LHelge/BCD-watch/HW/README.md

# Hardware
This directory contains all the hardware related stuff

## Datasheets
Documentation for the components used

## Libraries
Both symbol and footprint libraries for the PCB design

## PCB_CR2032
First version of the watch PCB, designed to use with a CR2043 battery
