LHelge/BCD-watch/HW/PCB_CR2032/README.md

# PCB_CR2032
Design of watch PCB to be used with a CR2032 coin cell battery

## Schematic
TODO: add this as images here

## BoM

Reference | Value | Make | Mouser part# | Part | Qty
--------- | ----- | ---- | ---- | ------ | ---
BT1 | CR2032 | Linx | 712-BAT-HLD-001 | BAT-HLD-001 | 1
C1, C2 | 20pF | Yageo | 603-CC805JRNPO9BN200 | CC0805JRNPO9BN200 | 2
C4-C9, C14, C15 | 100nF | Yageo | 603-CC805KRX7R9BB104 | CC0805KRX7R9BB104 | 8
C12 | 11mF | SII | 628-CPH3225A-2K | CPH3225A | 1
C3, C11, C13 | 10uF | Yageo | 603-CC805KKX7R6BB106 | CC0805KKX7R6BB106 | 3
D1-D3 | BAR43CFILM | ST | 511-BAR43CFILM | BAR43CFILM | 3
H00-H03,<br> H10-H13,<br> M00-M03,<br> M10-M13,<br> S00-S03,<br> S10-S13 | LED | Kingbright | 604-APTR3216SECKJ3 | APTR3216SECK/J3-PRV | 24
J1 | STDC14 | Amphenol  | 649-221121-00014T4LF | 20021121-00014T4LF | 1
R1-R20, R23-R26 | 1k | Yageo | 603-RC0805FR-071KL | RC0805FR-071KL | 24
R27-R31 | 10k | Yageo | 603-RC0805FR-0710KL | RC0805FR-0710KL | 5
SW1 | WAKE | Wurth | 710-434331045822 | 434331045822 | 1
U1 | STM32L071CBTx | ST | 511-STM32L071CBT6TR | STM32L071CBT6 | 1
U3 | LIS2DW12 | ST | 511-LIS2DW12TR | LIS2DW12TR | 1
Y1 | 32768 Hz | Epson Timing | 732-FC135-32.76KAA3 | FC-135 32.7680KA-A3 | 1
