LHelge/BCD-watch/HW/Datasheets/CPH3225A.PNG

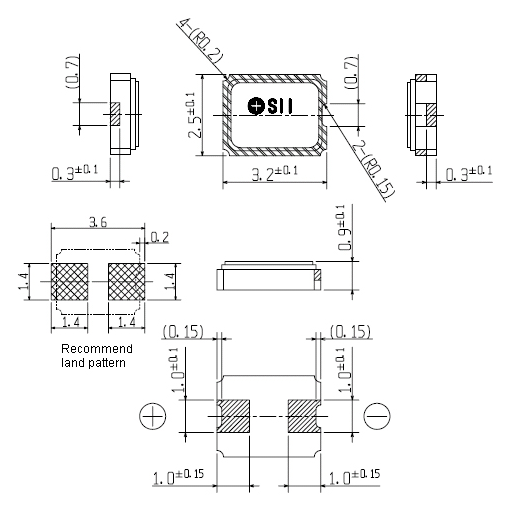
HW/Datasheets/CPH3225A.PNG
