LHelge/BCD-watch/HW/PCB_CR2032/order_v2.0/BoM.xlsx

Comment | Designator | Footprint | LCSC Part#
20pF | C1, C2 | C0603 | C1648
100nF | C4-C7, C9, C14, C15 | C0603 | C14663
10uF | C3, C13 | C0805 | C15850
10k | R27-R29, R31 | R0603 | C25804
100 | R30 | R0603 | C22775
LIS3DHTR | U2 | LGA16 | C15134
32.768kHz | Y1 | SMD-3215 | C32346
