LHelge/BCD-watch/HW/3D-print/Rev_2.0/Bottom.stl

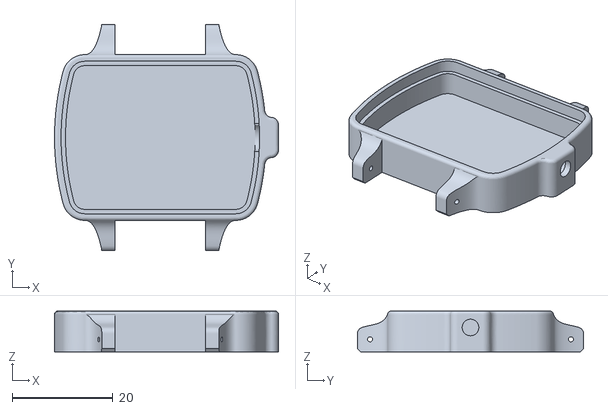
[picture p2: CAD file, 2020-01-15]
HW/3D-print/Rev_2.0/Bottom.stl
44.5 x 44.9 x 8.12
