LHelge/BCD-watch/HW/PCB_CR2032/outline.dxf

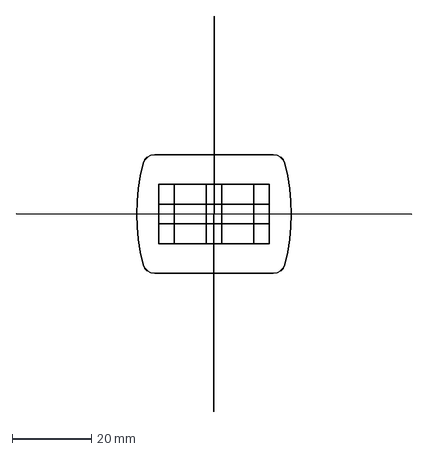
[picture p3: CAD file, 2019-11-13]
HW/PCB_CR2032/outline.dxf
100.0 x 100.0 mm
