LHelge/BCD-watch/HW/3D-print/Rev_2.0/Bottom-NoButton.stl

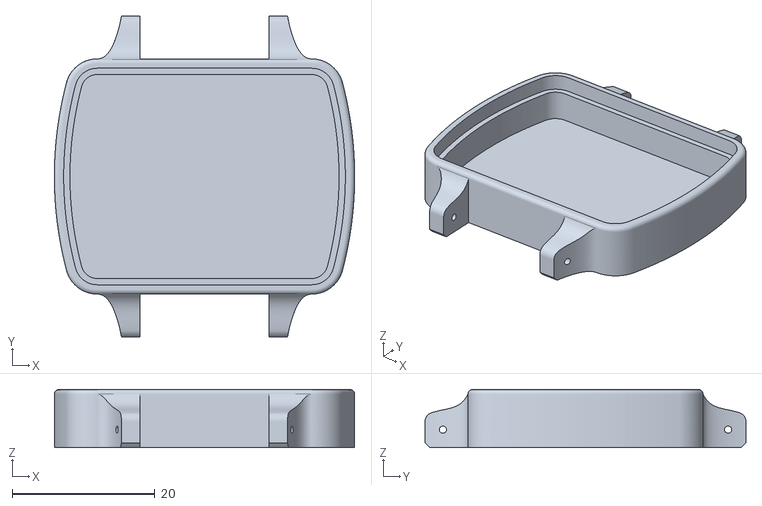
[picture p4: CAD file, 2020-01-15]
HW/3D-print/Rev_2.0/Bottom-NoButton.stl
42.0 x 44.9 x 8.12
