LHelge/BCD-watch/HW/3D-print/Rev_2.0/Clasp.stl

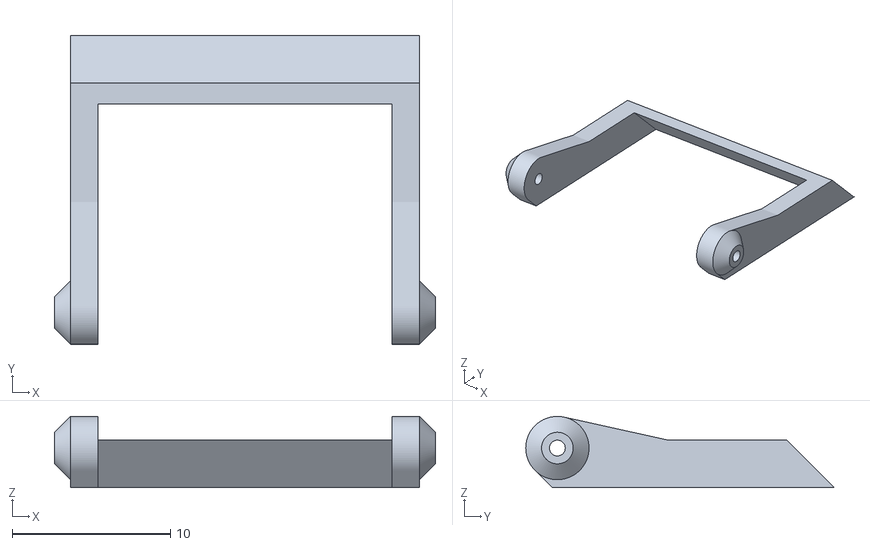
[picture p5: CAD file, 2019-11-18]
HW/3D-print/Rev_2.0/Clasp.stl
24.1 x 19.5 x 4.50
