LHelge/BCD-watch/HW/3D-print/Rev_2.0/WithoutClasp.stl

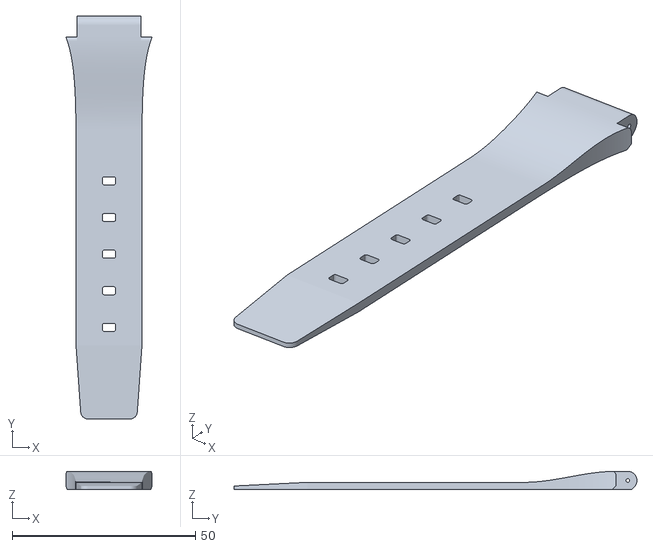
[picture p6: CAD file, 2019-11-18]
HW/3D-print/Rev_2.0/WithoutClasp.stl
23.5 x 110.0 x 5.00
