LHelge/BCD-watch/HW/3D-print/Rev_2.0/Loop.stl

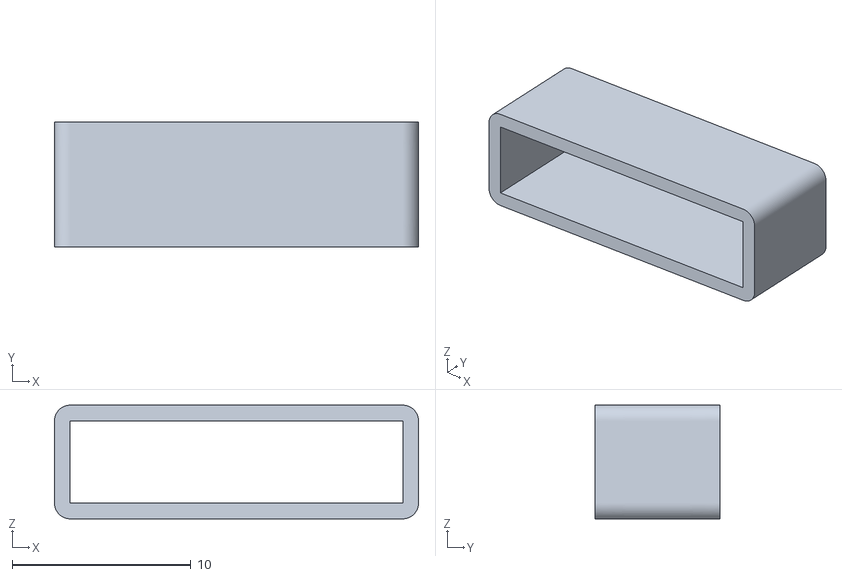
[picture p7: CAD file, 2019-11-13]
HW/3D-print/Rev_2.0/Loop.stl
20.4 x 7.00 x 6.36
