LHelge/BCD-watch/HW/3D-print/Rev_2.0/Top.stl

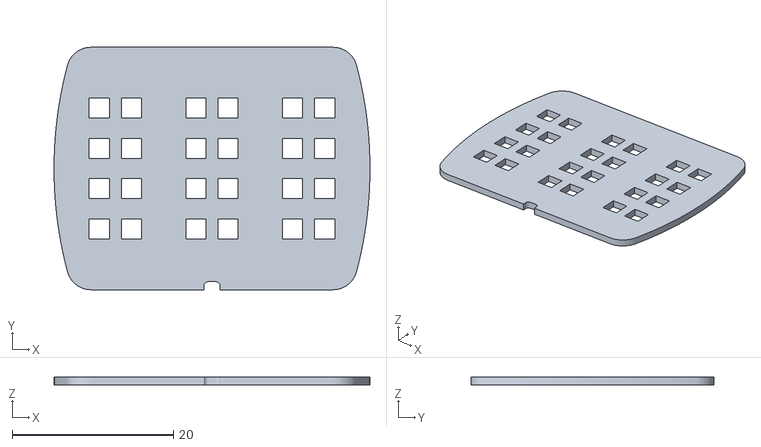
[picture p8: CAD file, 2019-11-13]
HW/3D-print/Rev_2.0/Top.stl
39.2 x 30.1 x 1.01
