LHelge/BCD-watch/HW/3D-print/Rev_2.0/WithClasp.stl

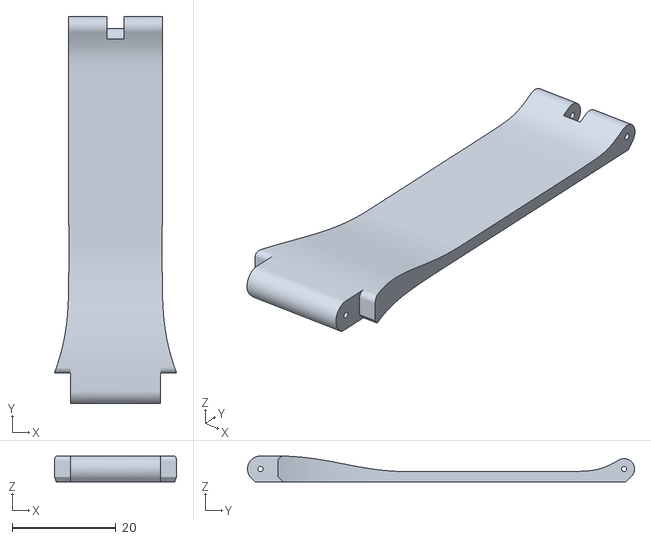
[picture p9: CAD file, 2019-11-13]
HW/3D-print/Rev_2.0/WithClasp.stl
23.5 x 74.5 x 5.00
