LHelge/BCD-watch/HW/3D-print/Rev_2.0/ClaspPin.stl

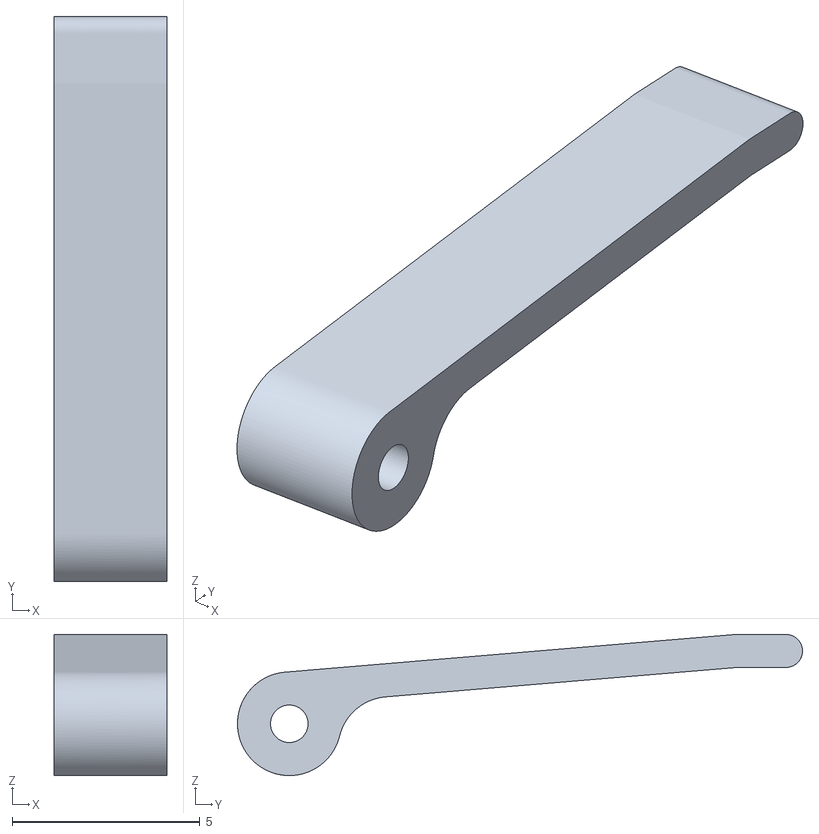
[picture p10: CAD file, 2019-11-11]
HW/3D-print/Rev_2.0/ClaspPin.stl
3.00 x 15.1 x 3.76
