LHelge/BCD-watch/HW/3D-print/Rev_2.0/ButtonInlay.stl

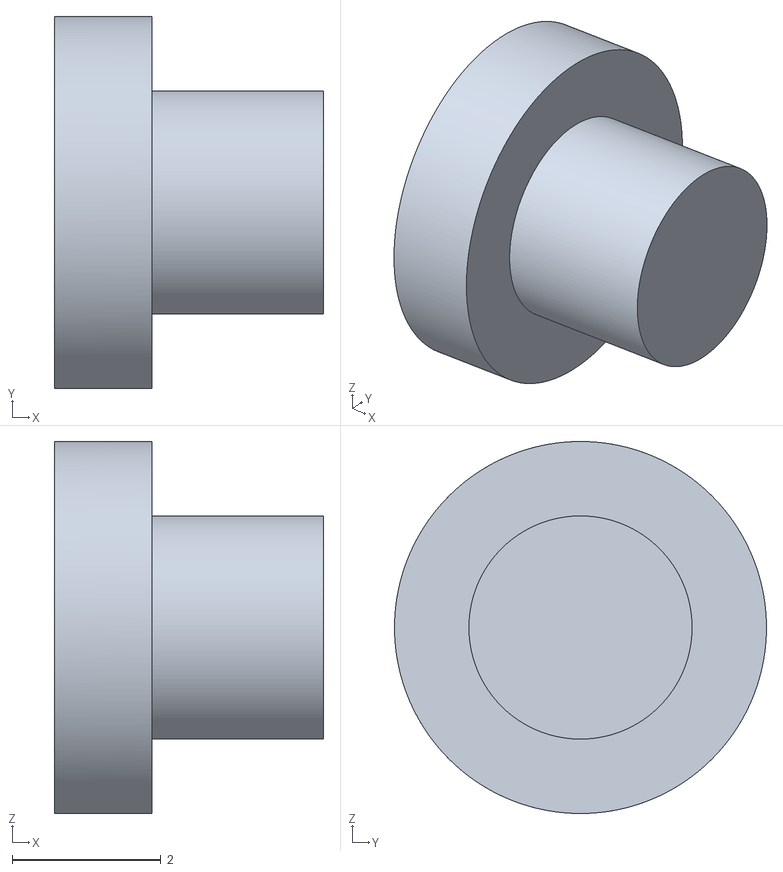
[picture p11: CAD file, 2019-11-11]
HW/3D-print/Rev_2.0/ButtonInlay.stl
3.62 x 5.00 x 5.00
