LHelge/BCD-watch/HW/3D-print/Rev_1.0/Clasp.stl

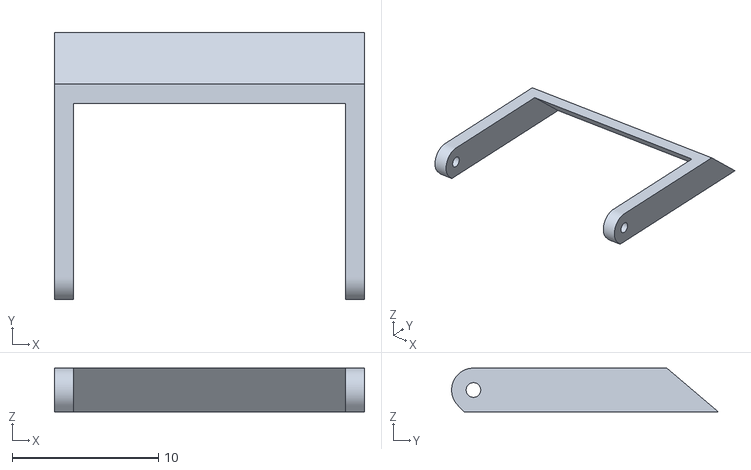
[picture p12: CAD file, 2019-11-11, an earlier design]
HW/3D-print/Rev_1.0/Clasp.stl
21.2 x 18.3 x 3.00
