LHelge/BCD-watch/HW/3D-print/Rev_1.0/BraceletWithoutClasp.stl

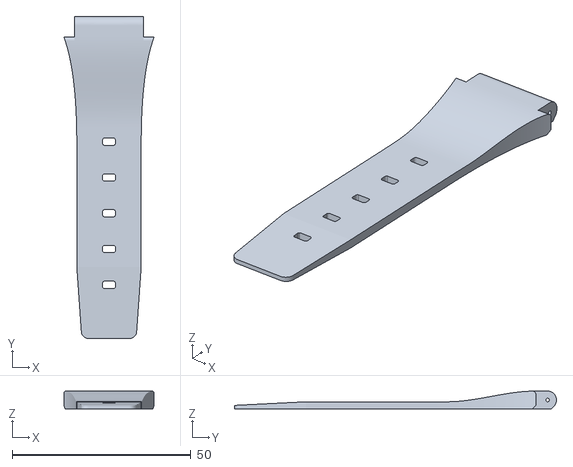
[picture p13: CAD file, 2019-11-11, an earlier design]
HW/3D-print/Rev_1.0/BraceletWithoutClasp.stl
25.2 x 90.0 x 5.00
