LHelge/BCD-watch/HW/3D-print/Rev_1.0/BraceletWithClasp.stl

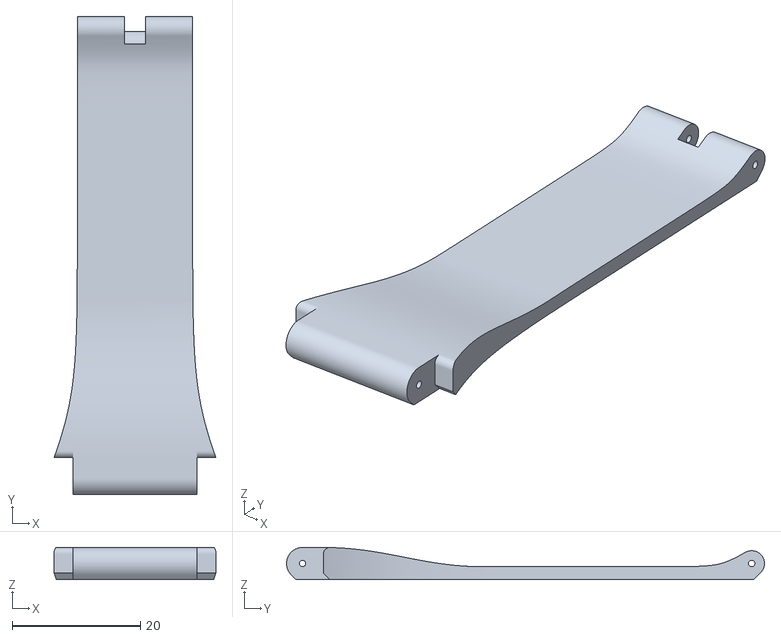
[picture p14: CAD file, 2019-11-11, an earlier design]
HW/3D-print/Rev_1.0/BraceletWithClasp.stl
25.2 x 74.5 x 5.00
