LHelge/BCD-watch/HW/3D-print/Rev_1.0/Bottom.stl

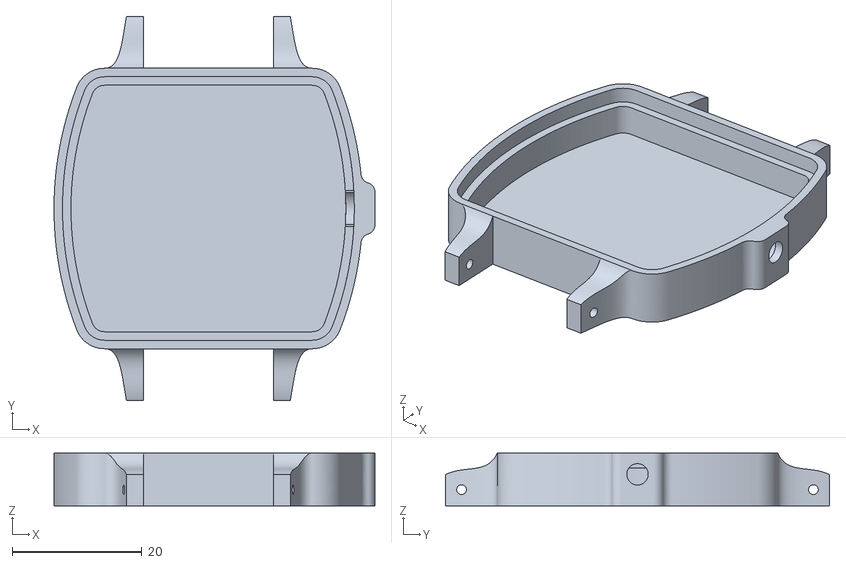
[picture p15: CAD file, 2019-11-11, an earlier design]
HW/3D-print/Rev_1.0/Bottom.stl
49.5 x 59.2 x 8.12
