LHelge/BCD-watch/HW/3D-print/Rev_1.0/Top.stl

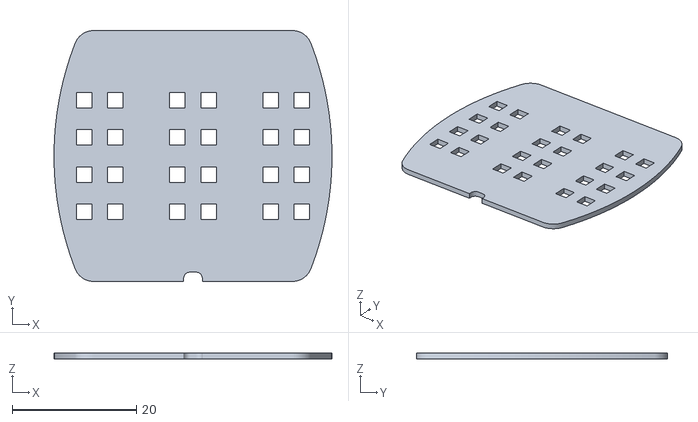
[picture p16: CAD file, 2019-11-11, an earlier design]
HW/3D-print/Rev_1.0/Top.stl
44.8 x 40.4 x 1.01
