LHelge/BCD-watch/(list of files, cad)

Other CAD files:
HW/3D-print/Rev_1.0/BraceletLoop.stl
