LHelge/BCD-watch/HW/3D-print/Rev_2.0/BCD-watch.png

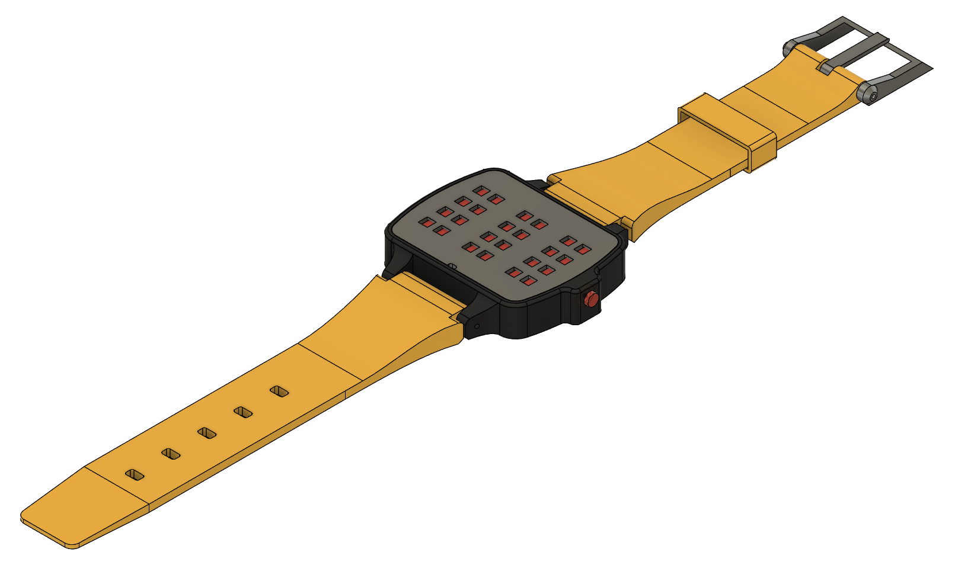
HW/3D-print/Rev_2.0/BCD-watch.png
