LHelge/BCD-watch/(threads)

Thread 1 (2019-11-08):

Perform schematics review before any serious layout work

LHelge, 2019-11-08:
The schematic has to be reviewed before any real effort into board layout.

abbeman, 2019-11-09:
Looked through the schematic. I say go!

Closed 2019-11-09.

Thread 3 (2019-11-08):

Order prototype PCBs

LHelge, 2019-11-08:
Plan to get first order from JLCpcb since they are usually quite fast

LHelge, 2019-11-10:
Done!

First prototype ordered from JLC PCB with SMT mounting service for some components on the backside. Mainly the accelerometer in LGA16 footprint.

Closed 2019-11-10.
