LHelge/BCD-watch/HW/PCB_CR2032/PCB_CR2032.kicad_pcb

## KiCad design HW/PCB_CR2032/PCB_CR2032.kicad_pcb (2019-12-15)

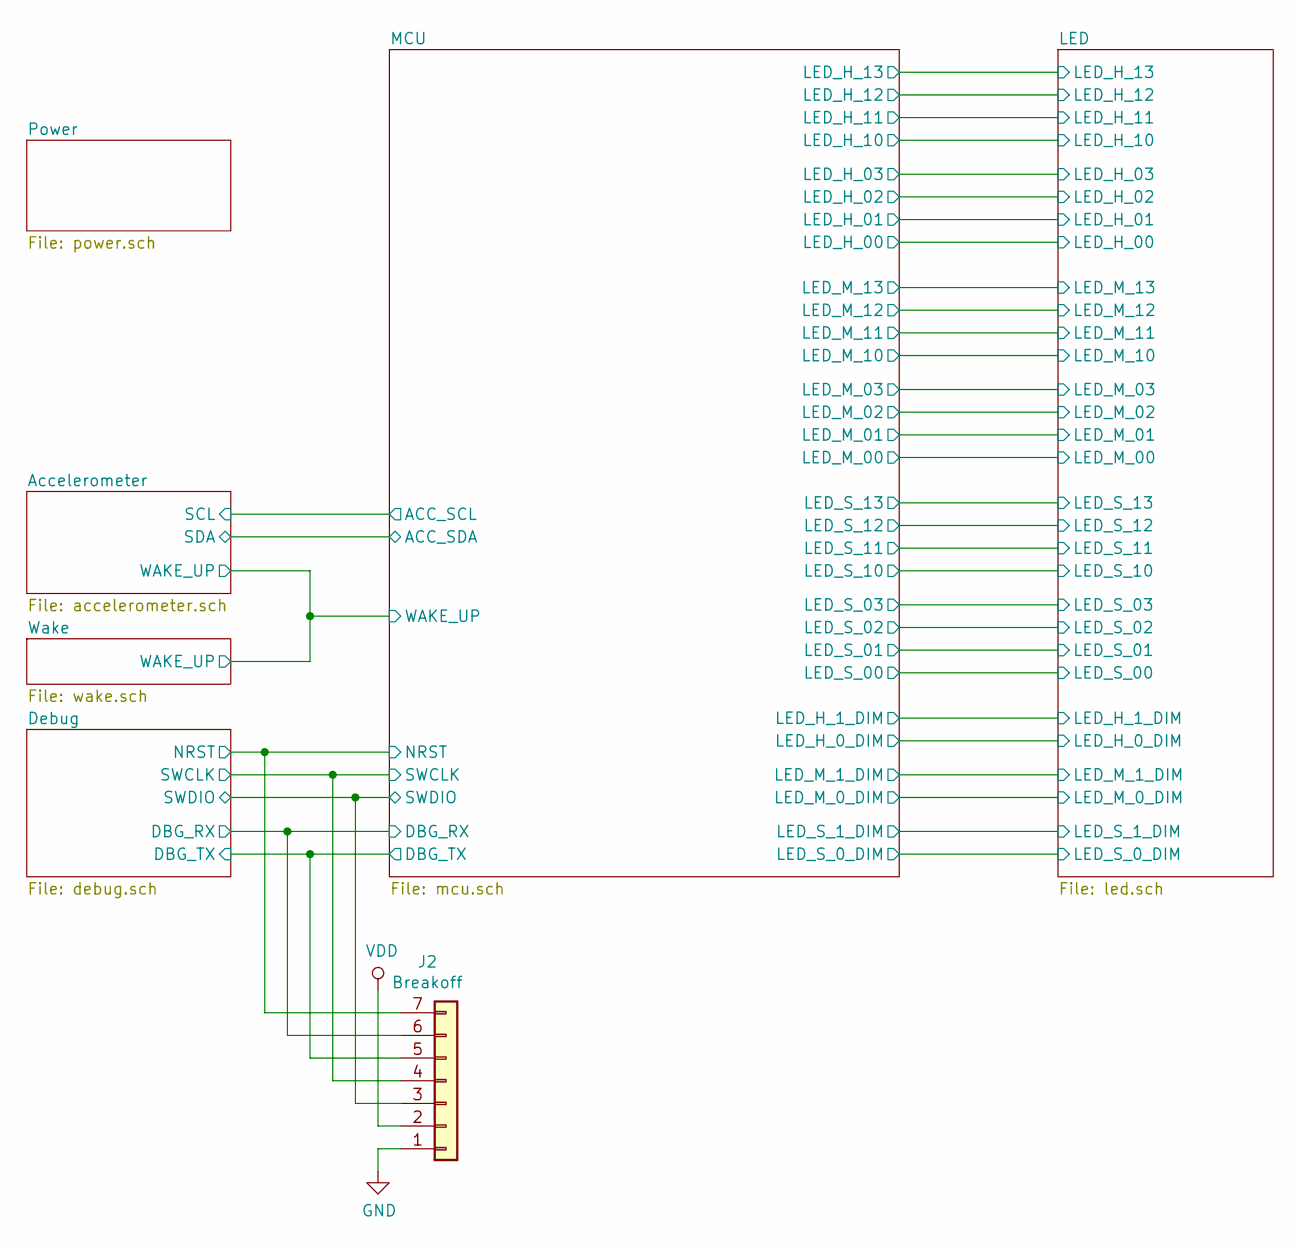
[picture p25: schematic PCB_CR2032.sch, BCD Watch]

Parts:
J2: Breakoff; PinHeader_1x07_P1.27mm_Vertical

Connections:
/Debug/DBG_RX: J2.6; also elsewhere on the board
/Debug/DBG_TX: J2.5; also elsewhere on the board
/Debug/NRST: J2.7; also elsewhere on the board
/Debug/SWCLK: J2.4; also elsewhere on the board
/Debug/SWDIO: J2.3; also elsewhere on the board
GND: J2.1; also elsewhere on the board
VDD: J2.2; also elsewhere on the board

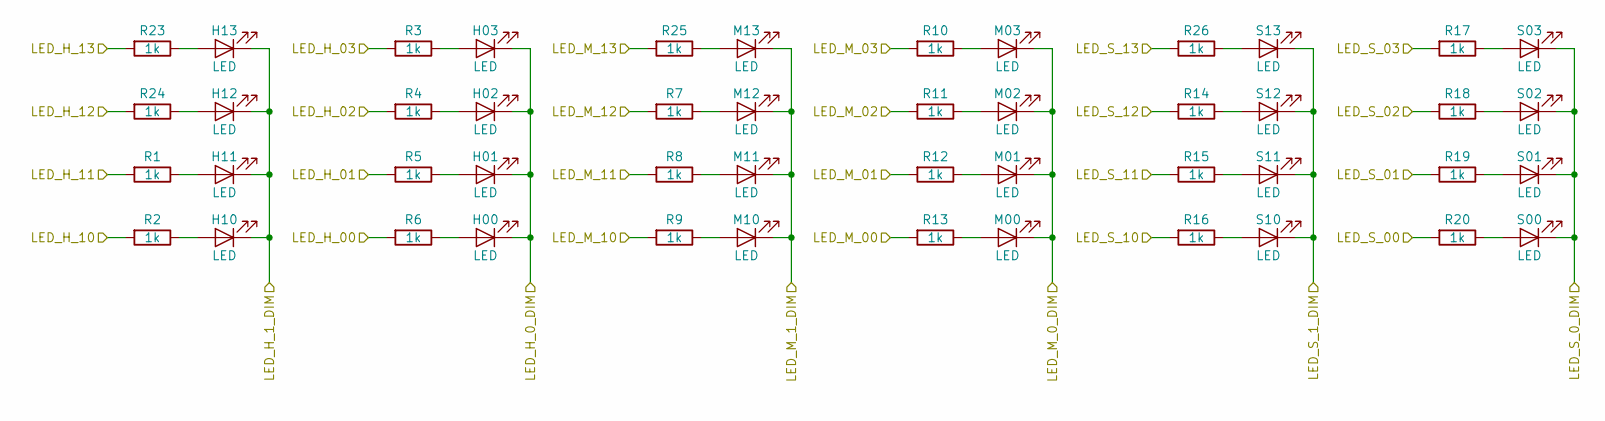
[picture p26: schematic led.sch, BCD Watch]

Parts:
H00, H01, H02, H03, H10, H11, H12, H13: LED; LED_1206_3216Metric; Part APTR3216SECK/J3-PRV; Mouser 604-APTR3216SECKJ3
M00, M01, M02, M03, M10, M11, M12, M13: LED; LED_1206_3216Metric; Part APTR3216SECK/J3-PRV; Mouser 604-APTR3216SECKJ3
R1, R2, R3, R4, R5, R6, R7, R8, R9, R10, R11, R12, R13, R14, R15, R16, R17, R18, R19, R20, R23, R24, R25, R26: 1k; R_0603_1608Metric_Pad1.05x0.95mm_HandSolder
S00, S01, S02, S03, S10, S11, S12, S13: LED; LED_1206_3216Metric; Part APTR3216SECK/J3-PRV; Mouser 604-APTR3216SECKJ3

Connections:
/Debug/DBG_RX: R23.2; also elsewhere on the board
/Debug/DBG_TX: R24.2; also elsewhere on the board
/LED/LED_H_00: R6.2; also elsewhere on the board
/LED/LED_H_0_DIM: H00.1 (K), H01.1 (K), H02.1 (K), H03.1 (K); also elsewhere on the board
/LED/LED_H_01: R5.2; also elsewhere on the board
/LED/LED_H_1_DIM: H10.1 (K), H11.1 (K), H12.1 (K), H13.1 (K); also elsewhere on the board
/LED/LED_H_02: R4.2; also elsewhere on the board
/LED/LED_H_03: R3.2; also elsewhere on the board
/LED/LED_H_10: R2.2; also elsewhere on the board
/LED/LED_H_11: R1.2; also elsewhere on the board
/LED/LED_M_00: R13.2; also elsewhere on the board
/LED/LED_M_0_DIM: M00.1 (K), M01.1 (K), M02.1 (K), M03.1 (K); also elsewhere on the board
/LED/LED_M_01: R12.2; also elsewhere on the board
/LED/LED_M_1_DIM: M10.1 (K), M11.1 (K), M12.1 (K), M13.1 (K); also elsewhere on the board
/LED/LED_M_02: R11.2; also elsewhere on the board
/LED/LED_M_03: R10.2; also elsewhere on the board
/LED/LED_M_10: R9.2; also elsewhere on the board
/LED/LED_M_11: R8.2; also elsewhere on the board
/LED/LED_M_12: R7.2; also elsewhere on the board
/LED/LED_M_13: R25.2; also elsewhere on the board
/LED/LED_S_00: R20.2; also elsewhere on the board
/LED/LED_S_0_DIM: S00.1 (K), S01.1 (K), S02.1 (K), S03.1 (K); also elsewhere on the board
/LED/LED_S_01: R19.2; also elsewhere on the board
/LED/LED_S_1_DIM: S10.1 (K), S11.1 (K), S12.1 (K), S13.1 (K); also elsewhere on the board
/LED/LED_S_02: R18.2; also elsewhere on the board
/LED/LED_S_03: R17.2; also elsewhere on the board
/LED/LED_S_10: R16.2; also elsewhere on the board
/LED/LED_S_11: R15.2; also elsewhere on the board
/LED/LED_S_12: R14.2; also elsewhere on the board
/LED/LED_S_13: R26.2; also elsewhere on the board
unnamed: H00.2 (A), R6.1
unnamed: H01.2 (A), R5.1
unnamed: H02.2 (A), R4.1
unnamed: H03.2 (A), R3.1
unnamed: H10.2 (A), R2.1
unnamed: H11.2 (A), R1.1
unnamed: H12.2 (A), R24.1
unnamed: H13.2 (A), R23.1
unnamed: M00.2 (A), R13.1
unnamed: M01.2 (A), R12.1
unnamed: M02.2 (A), R11.1
unnamed: M03.2 (A), R10.1
unnamed: M10.2 (A), R9.1
unnamed: M11.2 (A), R8.1
unnamed: M12.2 (A), R7.1
unnamed: M13.2 (A), R25.1
unnamed: R14.1, S12.2 (A)
unnamed: R15.1, S11.2 (A)
unnamed: R16.1, S10.2 (A)
unnamed: R17.1, S03.2 (A)
unnamed: R18.1, S02.2 (A)
unnamed: R19.1, S01.2 (A)
unnamed: R20.1, S00.2 (A)
unnamed: R26.1, S13.2 (A)

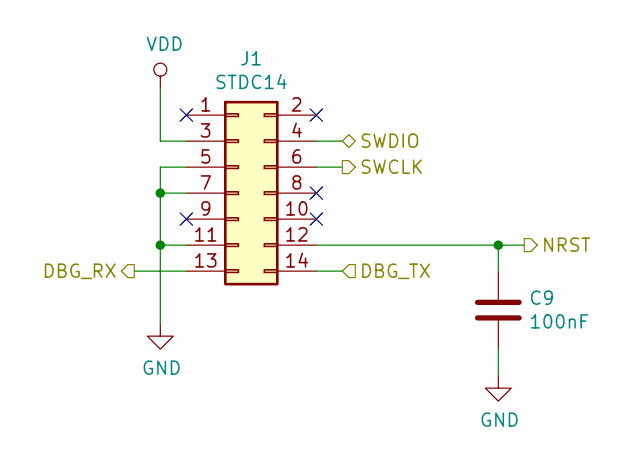
[picture p27: schematic debug.sch, BCD Watch]

Parts:
C9: 100nF; C_0603_1608Metric_Pad1.05x0.95mm_HandSolder; jlcpcb CC0603KRX7R9BB104
J1: STDC14; PinHeader_2x07_P1.27mm_Vertical_SMD; Part 20021121-00014T4LF; Mouser 649-221121-00014T4LF

Connections:
/Debug/DBG_RX: J1.13; also elsewhere on the board
/Debug/DBG_TX: J1.14; also elsewhere on the board
/Debug/NRST: C9.1, J1.12; also elsewhere on the board
/Debug/SWCLK: J1.6; also elsewhere on the board
/Debug/SWDIO: J1.4; also elsewhere on the board
GND: C9.2, J1.5, J1.7, J1.11; also elsewhere on the board
VDD: J1.3; also elsewhere on the board

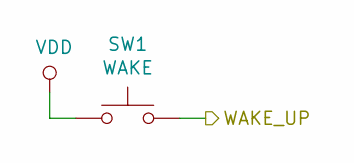
[picture p28: schematic wake.sch, BCD Watch]

Parts:
SW1: WAKE; WS-TASU SMT Tact Switch; Part 434331045822; Mouser 710-434331045822

Connections:
/Accelerometer/WAKE_UP: SW1.2; also elsewhere on the board
VDD: SW1.1; also elsewhere on the board

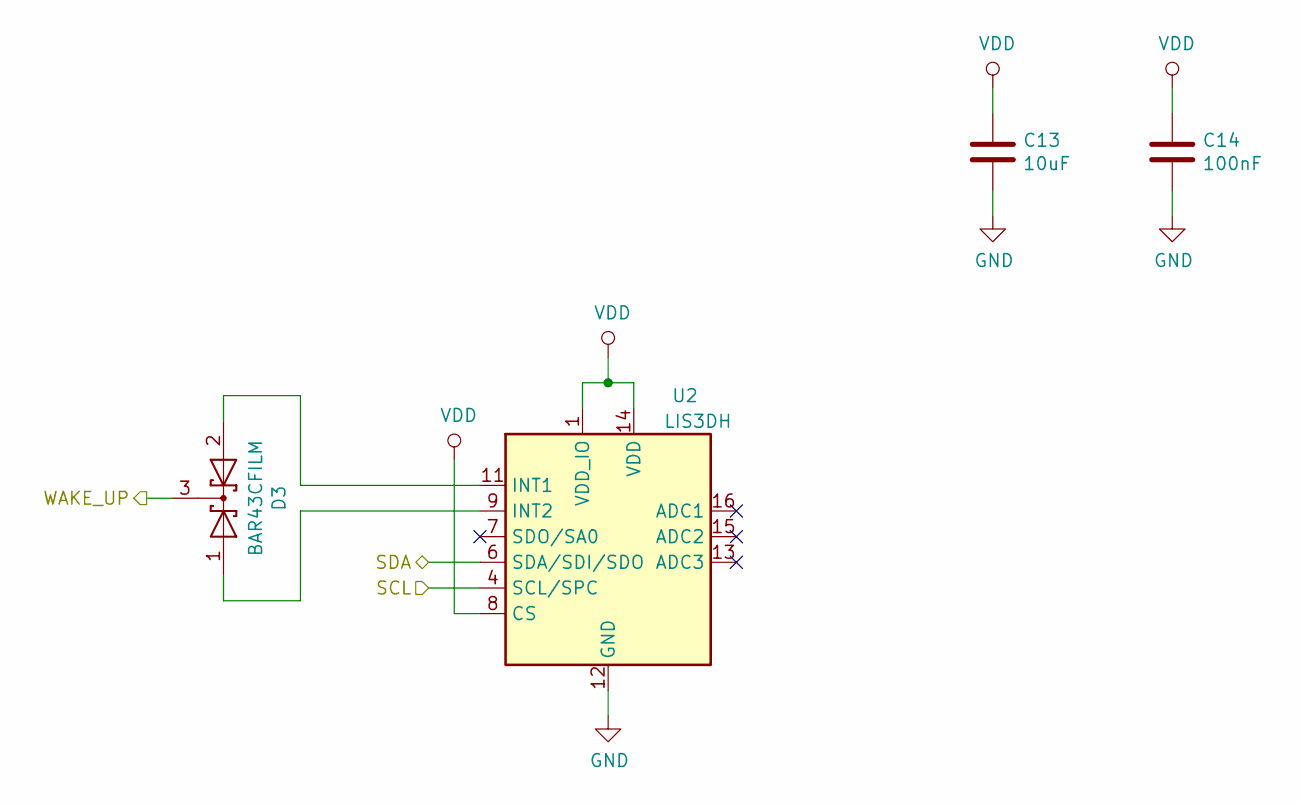
[picture p29: schematic accelerometer.sch]

Parts:
C13: 10uF; C_0805_2012Metric_Pad1.15x1.40mm_HandSolder; jlcpcb CL21A106KAYNNNE
C14: 100nF; C_0603_1608Metric_Pad1.05x0.95mm_HandSolder; jlcpcb CC0603KRX7R9BB104
D3: BAR43CFILM; SOT-23_Handsoldering; Part BAR43CFILM; Mouser 511-BAR43CFILM
U2: LIS3DH; LGA-16_3x3mm_P0.5mm_LayoutBorder3x5y; jlcpcb LIS3DHTR

Connections:
/Accelerometer/WAKE_UP: D3.3 (K); also elsewhere on the board
/MCU/ACC_SCL: U2.4 (SCL/SPC); also elsewhere on the board
/MCU/ACC_SDA: U2.6 (SDA/SDI/SDO); also elsewhere on the board
GND: C13.2, C14.2, U2.5 (GND), U2.10 (GND), U2.12 (GND); also elsewhere on the board
unnamed: D3.1 (A), U2.9 (INT2)
unnamed: D3.2 (A), U2.11 (INT1)
VDD: C13.1, C14.1, U2.1 (VDD_IO), U2.8 (CS), U2.14 (VDD); also elsewhere on the board

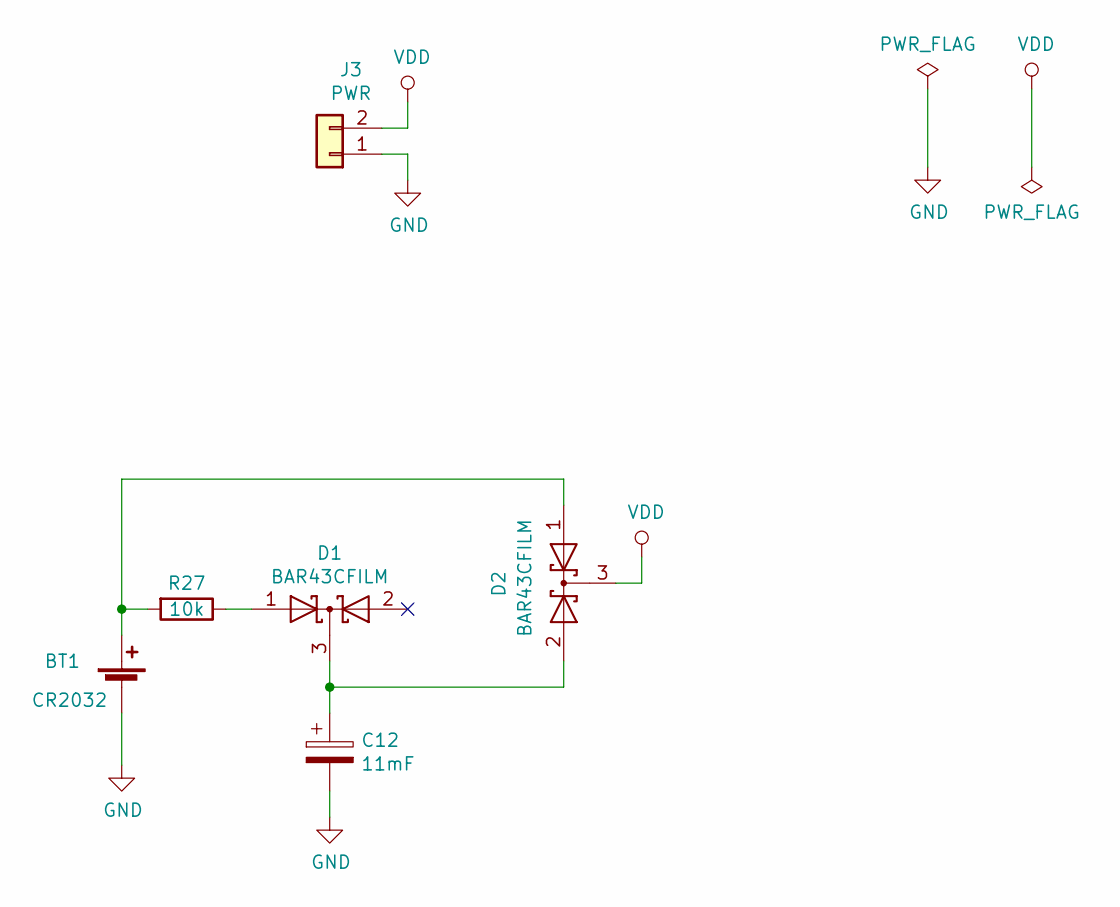
[picture p30: schematic power.sch]

Parts:
BT1: CR2032; BAT-HLD-001-xx-OTL; Part BAT-HLD-001; Mouser 712-BAT-HLD-001
C12: 11mF; CPH3225A; Part CPH3225A; Mouser 628-CPH3225A-2K
D1, D2: BAR43CFILM; SOT-23_Handsoldering; Part BAR43CFILM; Mouser 511-BAR43CFILM
J3: PWR; PinHeader_1x02_P1.27mm_Vertical
R27: 10k; R_0603_1608Metric_Pad1.05x0.95mm_HandSolder; LCSC C25804

Connections:
GND: BT1.2 (-), C12.2, J3.1; also elsewhere on the board
unnamed: BT1.1 (+), D2.1 (A), R27.2
unnamed: C12.1, D1.3 (K), D2.2 (A)
unnamed: D1.1 (A), R27.1
VDD: D2.3 (K), J3.2; also elsewhere on the board

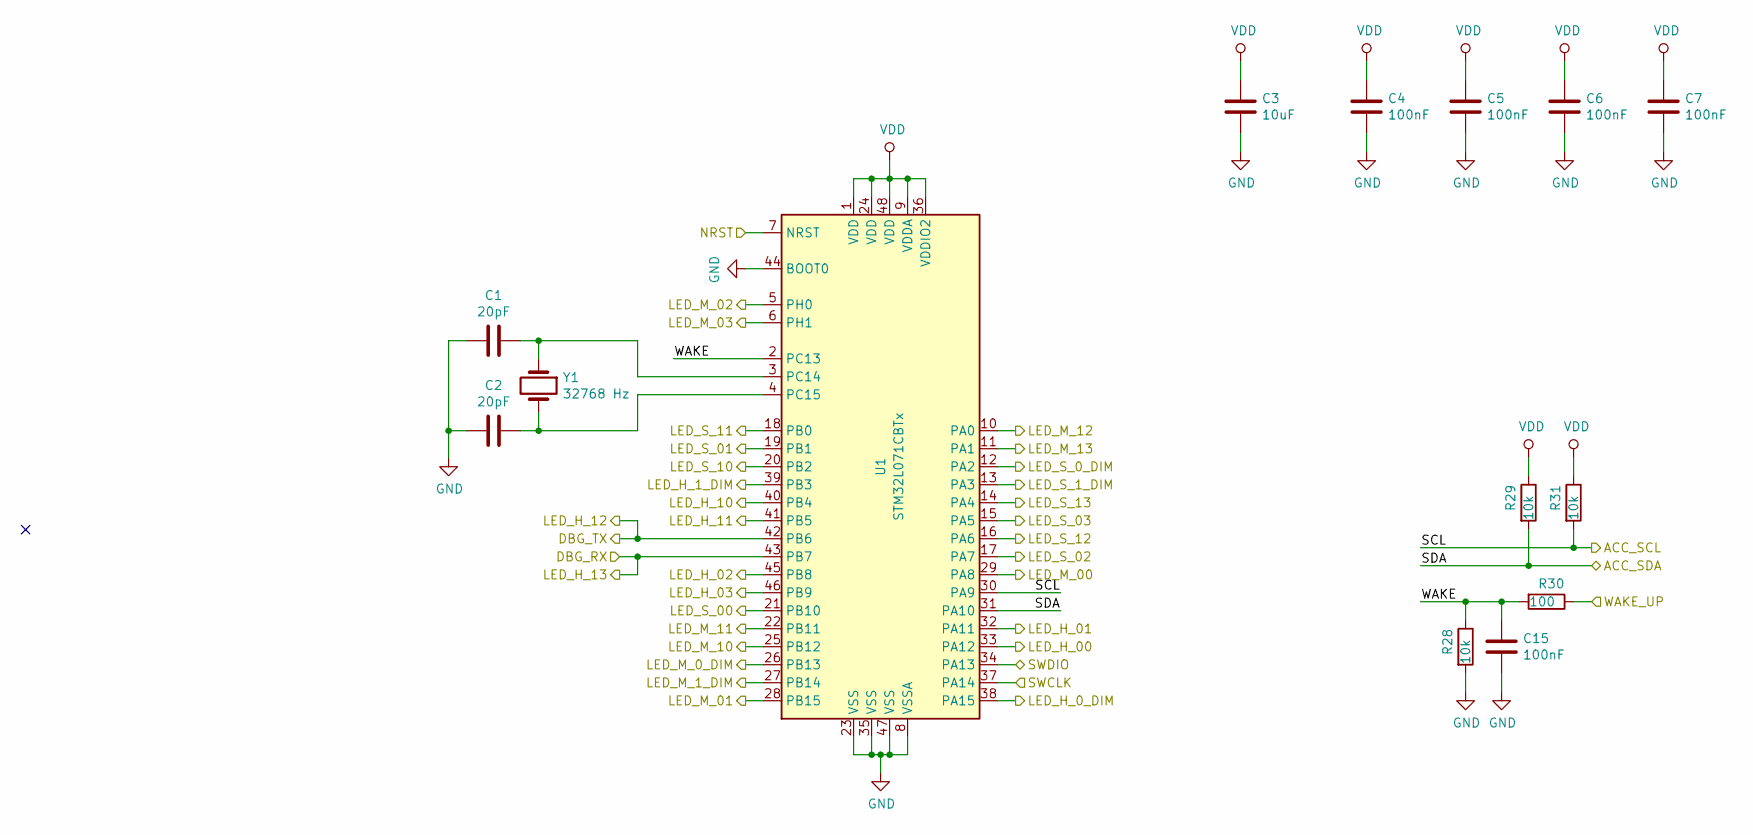
[picture p31: schematic mcu.sch, BCD Watch]

Parts:
C1, C2: 20pF; C_0603_1608Metric_Pad1.05x0.95mm_HandSolder; jlcpcb CL10C200JB8NNNC
C3: 10uF; C_0805_2012Metric_Pad1.15x1.40mm_HandSolder; jlcpcb CL21A106KAYNNNE
C4, C5, C6, C7, C15: 100nF; C_0603_1608Metric_Pad1.05x0.95mm_HandSolder; jlcpcb CC0603KRX7R9BB104
R28, R29, R31: 10k; R_0603_1608Metric_Pad1.05x0.95mm_HandSolder; LCSC C25804
R30: 100; R_0603_1608Metric_Pad1.05x0.95mm_HandSolder; LCSC C22775
U1: STM32L071CBTx; LQFP-48_7x7mm_P0.5mm; Part STM32L071CBT6; Mouser 511-STM32L071CBT6TR
Y1: 32768 Hz; FC-135; Part FC-135 32.7680KA-A3; Mouser 732-FC135-32.76KAA3

Connections:
/Accelerometer/WAKE_UP: R30.1; also elsewhere on the board
/Debug/DBG_RX: U1.43 (PB7); also elsewhere on the board
/Debug/DBG_TX: U1.42 (PB6); also elsewhere on the board
/Debug/NRST: U1.7 (NRST); also elsewhere on the board
/Debug/SWCLK: U1.37 (PA14); also elsewhere on the board
/Debug/SWDIO: U1.34 (PA13); also elsewhere on the board
/LED/LED_H_00: U1.33 (PA12); also elsewhere on the board
/LED/LED_H_0_DIM: U1.38 (PA15); also elsewhere on the board
/LED/LED_H_01: U1.32 (PA11); also elsewhere on the board
/LED/LED_H_1_DIM: U1.39 (PB3); also elsewhere on the board
/LED/LED_H_02: U1.45 (PB8); also elsewhere on the board
/LED/LED_H_03: U1.46 (PB9); also elsewhere on the board
/LED/LED_H_10: U1.40 (PB4); also elsewhere on the board
/LED/LED_H_11: U1.41 (PB5); also elsewhere on the board
/LED/LED_M_00: U1.29 (PA8); also elsewhere on the board
/LED/LED_M_0_DIM: U1.26 (PB13); also elsewhere on the board
/LED/LED_M_01: U1.28 (PB15); also elsewhere on the board
/LED/LED_M_1_DIM: U1.27 (PB14); also elsewhere on the board
/LED/LED_M_02: U1.5 (PH0); also elsewhere on the board
/LED/LED_M_03: U1.6 (PH1); also elsewhere on the board
/LED/LED_M_10: U1.25 (PB12); also elsewhere on the board
/LED/LED_M_11: U1.22 (PB11); also elsewhere on the board
/LED/LED_M_12: U1.10 (PA0); also elsewhere on the board
/LED/LED_M_13: U1.11 (PA1); also elsewhere on the board
/LED/LED_S_00: U1.21 (PB10); also elsewhere on the board
/LED/LED_S_0_DIM: U1.12 (PA2); also elsewhere on the board
/LED/LED_S_01: U1.19 (PB1); also elsewhere on the board
/LED/LED_S_1_DIM: U1.13 (PA3); also elsewhere on the board
/LED/LED_S_02: U1.17 (PA7); also elsewhere on the board
/LED/LED_S_03: U1.15 (PA5); also elsewhere on the board
/LED/LED_S_10: U1.20 (PB2); also elsewhere on the board
/LED/LED_S_11: U1.18 (PB0); also elsewhere on the board
/LED/LED_S_12: U1.16 (PA6); also elsewhere on the board
/LED/LED_S_13: U1.14 (PA4); also elsewhere on the board
/MCU/ACC_SCL: R31.2, U1.30 (PA9); also elsewhere on the board
/MCU/ACC_SDA: R29.2, U1.31 (PA10); also elsewhere on the board
/MCU/WAKE: C15.1, R28.1, R30.2, U1.2 (PC13)
GND: C1.2, C2.2, C3.2, C4.2, C5.2, C6.2, C7.2, C15.2, R28.2, U1.8 (VSSA), U1.23 (VSS), U1.35 (VSS), U1.44 (BOOT0), U1.47 (VSS); also elsewhere on the board
unnamed: C1.1, U1.3 (PC14), Y1.1
unnamed: C2.1, U1.4 (PC15), Y1.2
VDD: C3.1, C4.1, C5.1, C6.1, C7.1, R29.1, R31.1, U1.1 (VDD), U1.9 (VDDA), U1.24 (VDD), U1.36 (VDDIO2), U1.48 (VDD); also elsewhere on the board

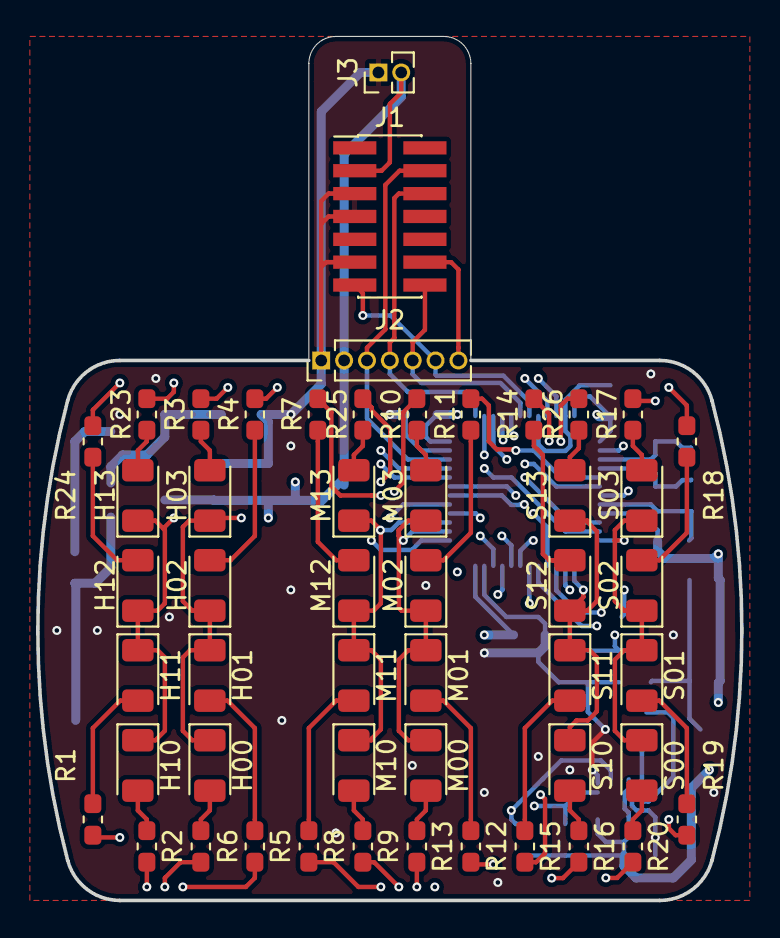
[picture p32: board PCB_CR2032.kicad_pcb from above]

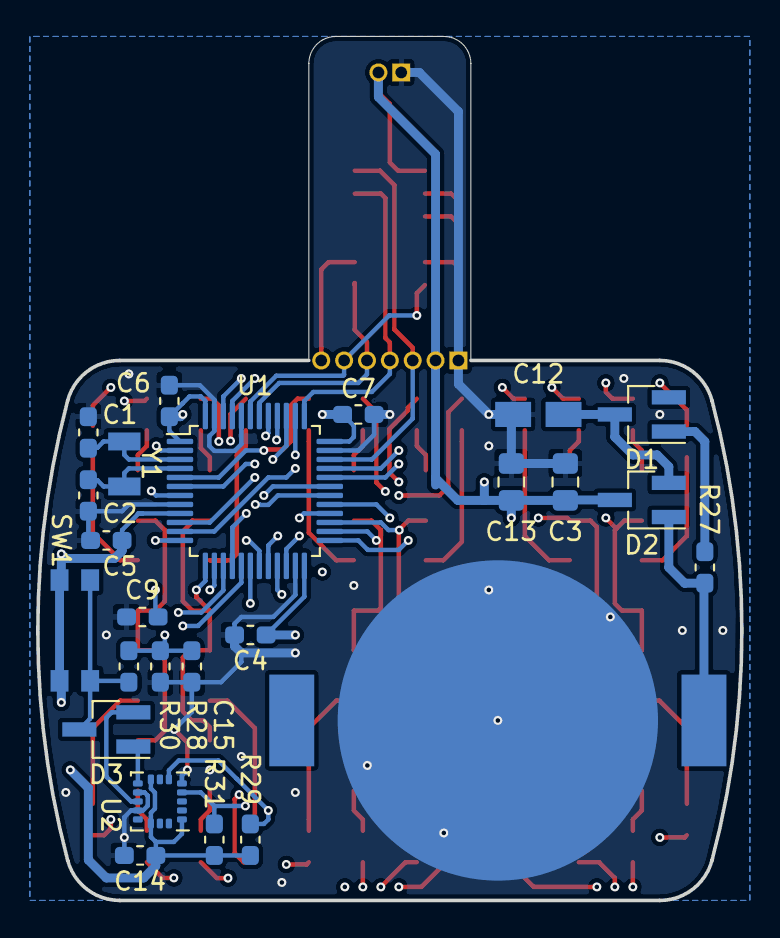
[picture p33: board PCB_CR2032.kicad_pcb from below]

Board: 4 copper layers, 39.1 x 48.0 mm, 76 parts (25 on the bottom side), 70 nets.
