LHelge/BCD-watch/FW/src/HAL/System.cpp

#include "System.hpp"

#include "stm32l0xx_ll_rcc.h"
#include "stm32l0xx_ll_pwr.h"
#include "stm32l0xx_ll_bus.h"
#include "stm32l0xx_ll_system.h"
#include "stm32l0xx_ll_cortex.h"
#include "stm32l0xx_ll_utils.h"

namespace System {

    volatile uint32_t System::m_delayCounter = 0;
    bool System::m_resumed = false;

    void System::Initialize(Debug::Mode mode) {
        LL_FLASH_SetLatency(LL_FLASH_LATENCY_1);

        if(LL_FLASH_GetLatency() != LL_FLASH_LATENCY_1)
        {
            while(1);
            // TODO
        }
        LL_PWR_SetRegulVoltageScaling(LL_PWR_REGU_VOLTAGE_SCALE1);
        LL_RCC_HSI_Enable();

        /* Wait till HSI is ready */
        while(LL_RCC_HSI_IsReady() != 1) {}

        LL_RCC_HSI_SetCalibTrimming(16);

        // LSE/RTC
        LL_APB1_GRP1_EnableClock(LL_APB1_GRP1_PERIPH_PWR);
        LL_PWR_EnableBkUpAccess();
        // Check if LSE is already running
        if(LL_RCC_LSE_IsReady() == 0) {
            LL_RCC_ForceBackupDomainReset();
            LL_RCC_ReleaseBackupDomainReset();
            LL_RCC_LSE_SetDriveCapability(LL_RCC_LSEDRIVE_HIGH);
            LL_RCC_LSE_Enable();

            /* Wait till LSE is ready */
            while(LL_RCC_LSE_IsReady() != 1) {}
        }
        LL_RCC_SetRTCClockSource(LL_RCC_RTC_CLKSOURCE_LSE);
        LL_RCC_EnableRTC();

        // Configure system clock to 32 MHz from HSI/PLL
        LL_RCC_PLL_ConfigDomain_SYS(LL_RCC_PLLSOURCE_HSI, LL_RCC_PLL_MUL_4, LL_RCC_PLL_DIV_2);
        LL_RCC_PLL_Enable();

        /* Wait till PLL is ready */
        while(LL_RCC_PLL_IsReady() != 1) {}

        LL_RCC_SetAHBPrescaler(LL_RCC_SYSCLK_DIV_1);
        LL_RCC_SetAPB1Prescaler(LL_RCC_APB1_DIV_1);
        LL_RCC_SetAPB2Prescaler(LL_RCC_APB2_DIV_1);
        LL_RCC_SetSysClkSource(LL_RCC_SYS_CLKSOURCE_PLL);

        /* Wait till System clock is ready */
        while(LL_RCC_GetSysClkSource() != LL_RCC_SYS_CLKSOURCE_STATUS_PLL) {}

        // Check if system aws resumed from standby
        System::m_resumed = false;
        if (LL_PWR_IsActiveFlag_SB() != 0)
        { 
            System::m_resumed = true;

            LL_PWR_ClearFlag_SB(); 
        }

        // Check and Clear the Wakeup flag
        if (LL_PWR_IsActiveFlag_WU() != 0)
        {
            LL_PWR_ClearFlag_WU();
        }

        LL_SYSTICK_SetClkSource(LL_SYSTICK_CLKSOURCE_HCLK);
        LL_SetSystemCoreClock(32000000);
        
        LL_RCC_SetUSARTClockSource(LL_RCC_USART1_CLKSOURCE_PCLK2);
        LL_RCC_SetI2CClockSource(LL_RCC_I2C1_CLKSOURCE_PCLK1);

        if(mode == Debug::DebugMode) {
            // In debug mode, keep SWD active in standby mode
            LL_DBGMCU_EnableDBGStandbyMode();
        }
    }

    uint32_t System::GetCoreClock() {
        return 32000000;
    }

    void System::EnableClock(const ClockHW clock) {
        switch(clock) {
            case GpioA: LL_IOP_GRP1_EnableClock(LL_IOP_GRP1_PERIPH_GPIOA)   ;break;
            case GpioB: LL_IOP_GRP1_EnableClock(LL_IOP_GRP1_PERIPH_GPIOB)   ;break;
            case GpioC: LL_IOP_GRP1_EnableClock(LL_IOP_GRP1_PERIPH_GPIOC)   ;break;
            case GpioD: LL_IOP_GRP1_EnableClock(LL_IOP_GRP1_PERIPH_GPIOD)   ;break;
            case GpioE: LL_IOP_GRP1_EnableClock(LL_IOP_GRP1_PERIPH_GPIOE)   ;break;
            case GpioH: LL_IOP_GRP1_EnableClock(LL_IOP_GRP1_PERIPH_GPIOH)   ;break;
            case Tim2:  LL_APB1_GRP1_EnableClock(LL_APB1_GRP1_PERIPH_TIM2)  ;break;
            case Tim21: LL_APB2_GRP1_EnableClock(LL_APB2_GRP1_PERIPH_TIM21) ;break;
            case I2c1:  LL_APB1_GRP1_EnableClock(LL_APB1_GRP1_PERIPH_I2C1)  ;break;
            case Usart1: LL_APB2_GRP1_EnableClock(LL_APB2_GRP1_PERIPH_USART1) ;break;
            default:
                // TODO: Assert
                break;
        }
    }

    void System::Reset() {
        NVIC_SystemReset();
    }

    void System::Standby(const Wakeup wakeup) {
        LL_PWR_DisableWakeUpPin(wakeup);
        LL_PWR_ClearFlag_WU();
        LL_PWR_EnableWakeUpPin(wakeup);
        LL_PWR_ClearFlag_WU();
        LL_PWR_EnableUltraLowPower();
        LL_PWR_SetPowerMode(LL_PWR_MODE_STANDBY);
        LL_LPM_EnableDeepSleep();

        #if defined ( __CC_ARM)
            __force_stores();
        #endif
        
        __WFI();
    }


    bool System::IsResumed() {
        return System::m_resumed;
    }
}
