LHelge/BCD-watch/(commit log)

2019-11-07 Initial commit of hardware. Rev 0.2 of coin cell PCB
    [PCB_CR2032.kicad_pcb, PCB_CR2032.sch, accelerometer.sch, debug.sch, led.sch, mcu.sch, outline.dxf, power.sch]
2019-11-07 Initial commit of firmware. Blank generated STM32CubeMX makefile project with pin configuration set according to schematic rev v 0.2
2019-11-08 Added reference manual for MCU and datasheet for good LED candidate
2019-11-08 * Updated Schematic with 1206 leds and 1k 0805 current limiting resistors
    * Restored STDC14 and debug UART, now shared with top led of minute and second. Some other LED pins remapped
    * Updated STM32CubeMX project to reflect schematic changes and generated code again
    [PCB_CR2032.sch, accelerometer.sch, debug.sch, led.sch, mcu.sch, power.sch]
2019-11-08 * Corrected LED references in schematic
    * Corrected value of oscillator load capacitors
    * Added HW readme with BoM
    [led.sch, mcu.sch]
2019-11-10 Created layout for CR2032 version 1.0, for first prototype order, resulted in a lot of changes in the pin-mapping to make routing easier.
    [BoM.xlsx, PCB_CR2032.kicad_pcb, PCB_CR2032.sch, accelerometer.sch, debug.sch, led.sch, mcu.sch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]
2019-11-11 Added 3D-printable watch for rev 1.0 boards
    [Bottom.stl, BraceletLoop.stl, BraceletWithClasp.stl, BraceletWithoutClasp.stl, ButtonInlay.stl, Clasp.stl, ClaspPin.stl, Top.stl]
2019-11-12 Compilable generated STM32CubeMX project
2019-11-13 Worked on Rev 2.0 HW with smaller size.
    [Bottom.stl, Loop.stl, PCB_CR2032.kicad_pcb, PCB_CR2032.sch, Top.stl, WithClasp.stl, WithoutClasp.stl, accelerometer.sch]
2019-11-14 Worked some more on rev 2.0 schematic. Almost done! Also added 3D-model of battery holder to library.
    [PCB_CR2032.kicad_pcb, accelerometer.sch, wake.sch]
2019-11-18 updated Rev_2.0 3d-priont files after first print with some small modifications.
    [Bottom.stl, BraceletLoop.stl, BraceletWithClasp.stl, BraceletWithoutClasp.stl, ButtonInlay.stl, Clasp.stl, ClaspPin.stl, Loop.stl]
2019-11-20 Connected BOOT0 pin to GND after forst board bring up.
    [PCB_CR2032.kicad_pcb, mcu.sch]
2019-11-20 Tested leds and button during board bring-up
2019-11-21 Tested PWM functions successfully
2019-11-21 Added code for UART, not working yet, probably something with clock/baudrate.
2019-11-24 Got Accelerometer to work as well.
2019-11-27 Added button press and accelerometer interrupt wakeup.
2019-12-15 Ordered V2.0 PCB
    [BoM.xlsx, PCB_CR2032.kicad_pcb, mcu.sch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]
2019-12-27 Bugfix to statemachine and a way to see if system was resumed from standby
    [StateMachine.cpp, System.cpp, System.hpp]
2020-01-01 Solved some bugs wiht accelerometer and RTC, basic functionality to set and display time all there.
    [App.cpp, BCDWatch.cpp, BCDWatch.hpp, LIS3DH.cpp, LIS3DH.hpp, RTC.cpp, System.cpp, System.hpp]
2020-01-14 Fix includes for case sensitive file systems
    [Button.cpp, Button.hpp, Display.hpp, GPIO.cpp, LIS3DH.cpp, UART.hpp]
2020-01-15 Updated some 3d-print models
    [Bottom-NoButton.stl, Bottom.stl, ButtonInlay.stl]
2020-01-15 Added acceleration vector to debug print
2020-01-15 Tested helper functions for reading multiple byte values from I2C
2020-01-16 Wrapped FreeRTOS queues as well.
    Replaced StateMAchine with a separate Task and the internal event queue with a FreeRTOS queue.
    [App.cpp, Events.hpp, StateMachine.cpp, StateMachine.hpp]
2020-01-17 More FreeRTOS additions: * Timers * StreamBuffers (Not tested) * MessageBuffers (Not tested)
    Some changes to the app as well.
    TODO: Put accelerometer driver in a task.
2020-01-20 Fix for case sensitive FS
2020-01-20 Use enum for debug-param
    Use enum rather than bool for debug param for increased readability, and
    also moving an ifdef to the Debug class so that it won't have to be
    sprinkled across the code.
    [App.cpp, BCDWatch.cpp, BCDWatch.hpp, Debug.hpp, System.cpp, System.hpp]
2020-01-30 Made Accelerometer run in a thread and added tilt events
2020-02-05 New take on button-events
    Press then release less than press-timeout: button press.
    Press then release longer than press-timeout: long press.
    Button press then press-release longer than press-timeout: button hold.
    Also, while setting time, ticking minutes from 59 to 0 won't tick
    hours. Dim the number you're not currently setting.
    Also fix LED transition flicker.
    [Button.cpp, RTC.hpp]
